LaskaKit/ESP32-LPKit/SW/ESP32-LPkit_SCD41_TMEPcz/README.md

# Výstup

Vystup dat
