LaskaKit/ESP32-LPKit/SW/ESP32-LPkit_SHT40_TMEPcz/README.md

# Výstup

Vystup dat

# Nastavení čidla

Nastaveni cidla

# Možnost debugování

debug

debug
