LaskaKit/ESP32-LPKit/img/esp32-lpkit-1.jpg

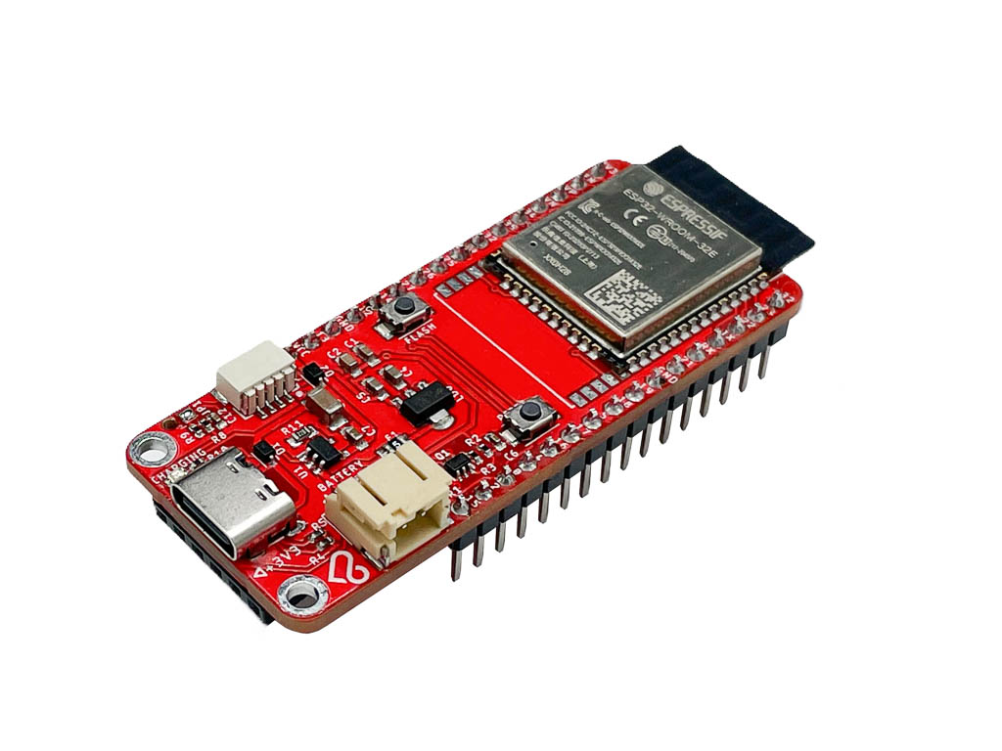
img/esp32-lpkit-1.jpg
