LaskaKit/ESP32-LPKit/img/esp32-lpkit-2.jpg

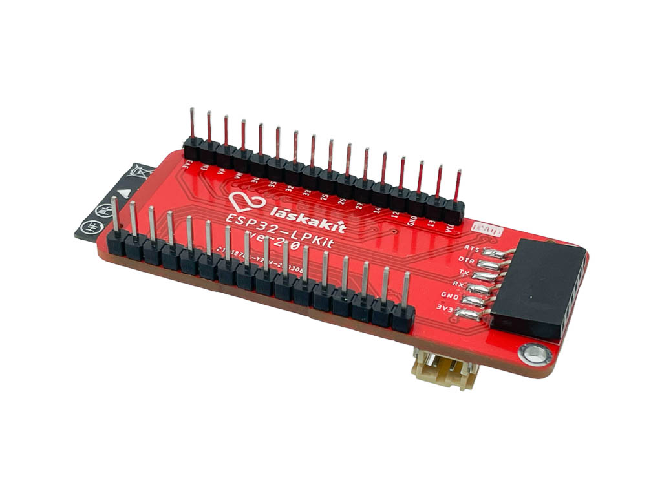
img/esp32-lpkit-2.jpg
