LaskaKit/ESP32-LPKit/img/esp32-lpkit-back.jpg

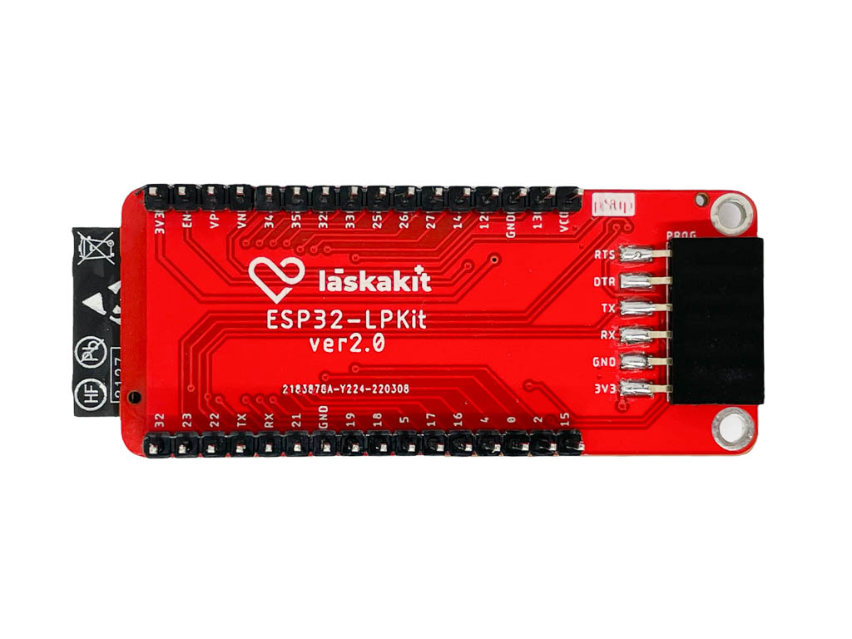
img/esp32-lpkit-back.jpg
