LaskaKit/ESP32-LPKit/img/esp32-lpkit-front.jpg

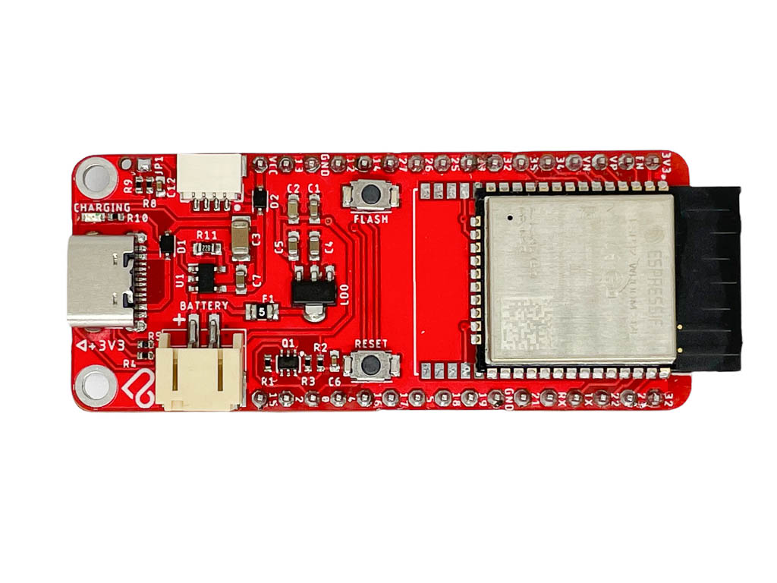
img/esp32-lpkit-front.jpg
