LaskaKit/ESP32-LPKit/img/esp32-lpkit-front_popis.jpg

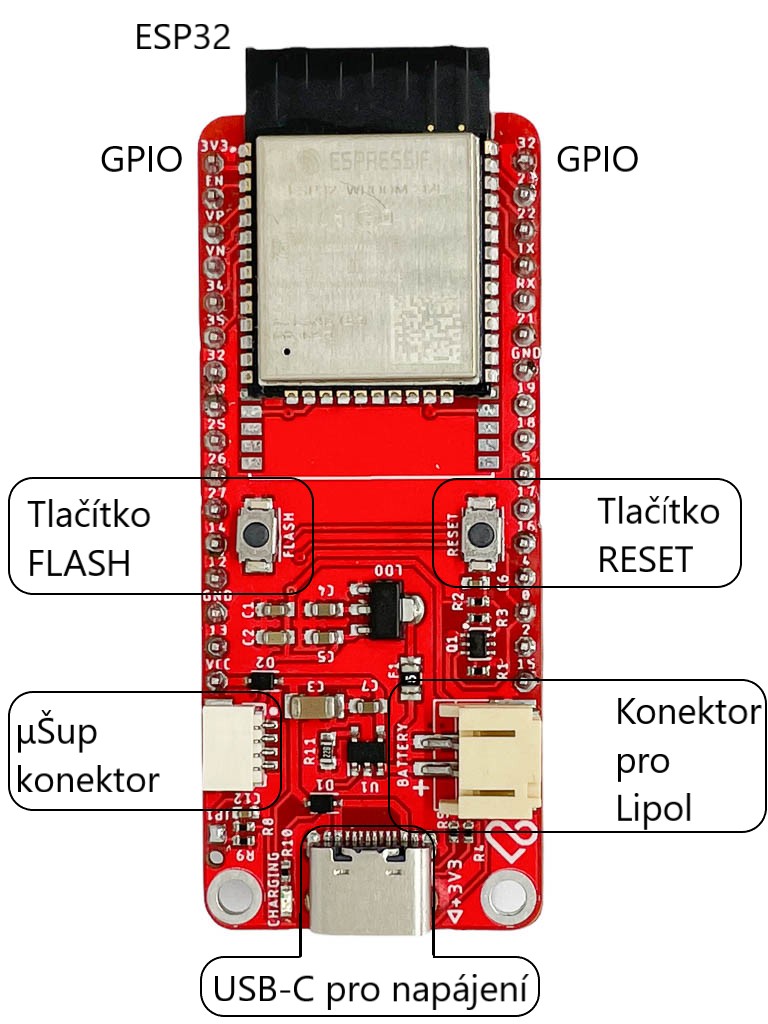
img/esp32-lpkit-front_popis.jpg
