LaskaKit/ESP32-LPKit/img/ESP32-LPkit_pinout.JPG

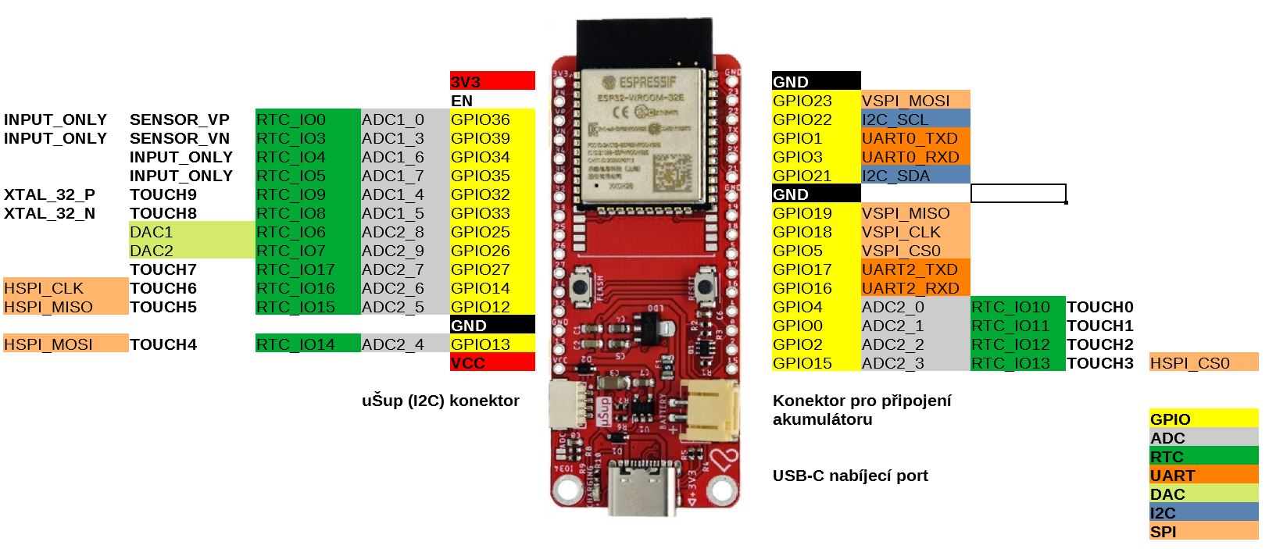
img/ESP32-LPkit_pinout.JPG
