LaskaKit/ESP32-LPKit/img/ESP32LPkit1.jpg

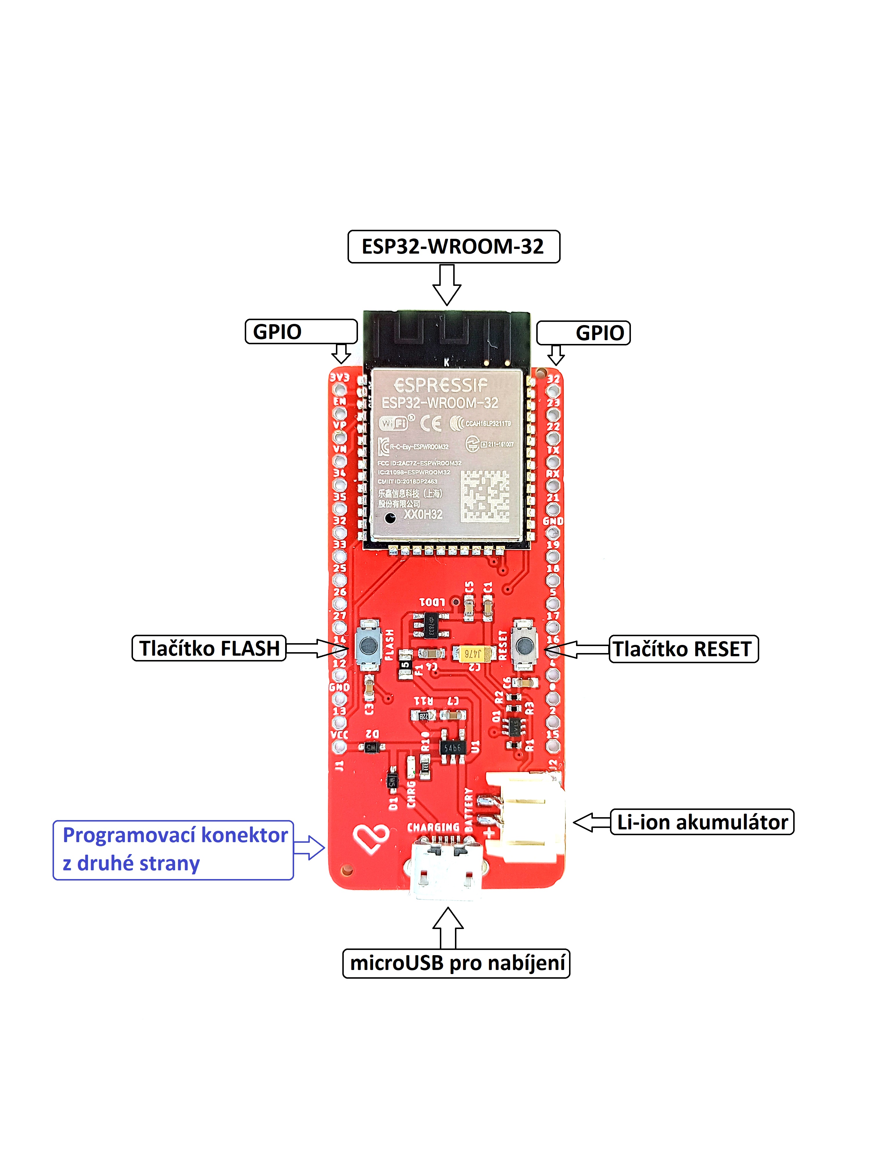
img/ESP32LPkit1.jpg
