LaskaKit/ESP32-LPKit/HW/ESP32-LPKit_V2.4.pdf

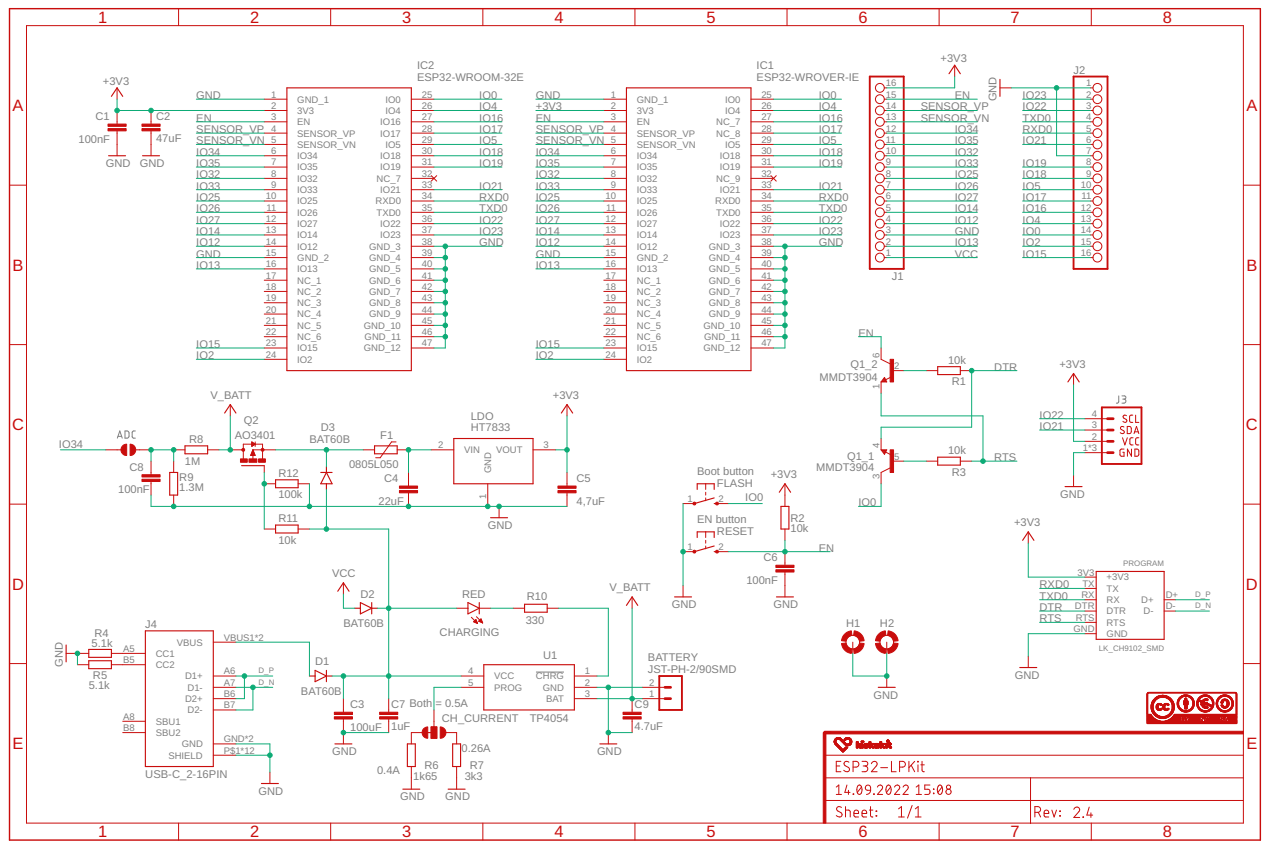
[picture p12: page 1]

39 GND_5 | GND 15 | 39 GND_5
40 GND_6 | | 40 GND_6
41 GND_7 | | 41 GND_7
42 GND_8 | | 42 GND_8
43 GND_9 | | 43 GND_9
44 GND_10 | | 44 GND_10
45 GND_11 | | 45 GND_11

Boot button EN button GND
