LaskaKit/ESP32-LPKit/HW/ESP32-LPKit_V2.2.pdf

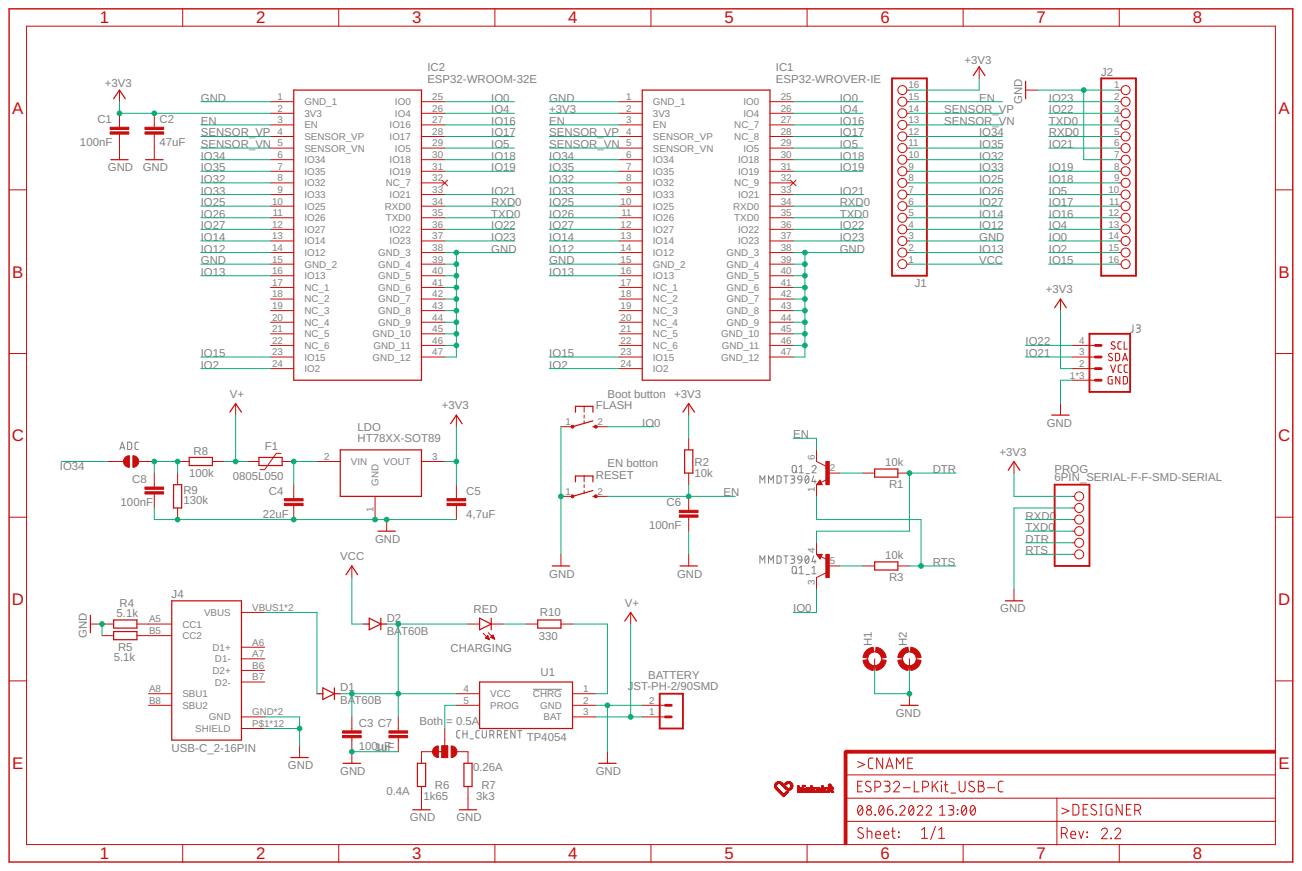
[picture p13: page 1]

Boot button EN botton
