LaskaKit/ESP32-LPKit/HW/old/ESP32-LPKit.pdf

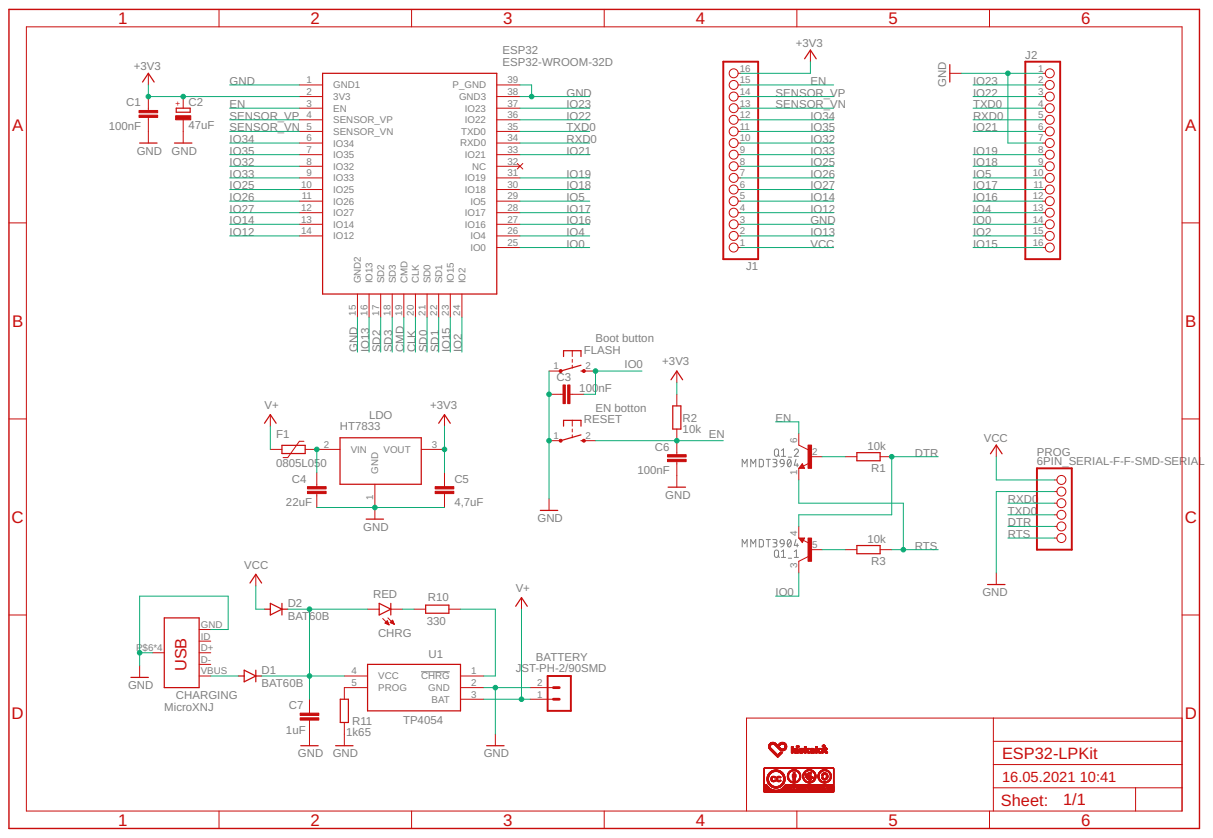
[picture p14: page 1]
