LaskaKit/ESP32-LPKit/SW/ESP32_LPkit_ADC/ESP32_LPkit_ADC.ino

/*
* Example code for ESP32-LPkit evaluation board made by laskakit.cz
* Firmware sends voltage od pin 34 through serial com port (UART)
* "laskakit.cz" 
* "ESP32 LP-kit"
* The message is sent every second
*
* Created by (c) laskakit.cz 2022
*/

#include <SPI.h>
#include <Wire.h>

#define ADCpin 34
#define deviderRatio 1.7693877551  // Voltage devider ratio on ADC pin 1MOhm + 1.3MOhm
    
void setup() {
    
  Serial.begin(115200);
  delay(100); // let serial console settle
}

void loop() {

  float bat_voltage = analogReadMilliVolts(ADCpin) * deviderRatio / 1000;
  Serial.print("Battery Voltage = " );
  Serial.print(bat_voltage);
  Serial.println("V");

  delay(2000);
}
