LaskaKit/ESP32-LPKit/SW/ESP32_LPkit_UART/ESP32_LPkit_UART.ino

/*
* Example code for ESP32-LPkit evaluation board made by laskakit.cz
* Firmware sends message through serial com port (UART)
* "laskakit.cz" 
* "ESP32 LP-kit"
* The message is sent every second
*
* Created by (c) laskakit.cz 2021
*
* Libraries:
* -
*/
 
void setup() {
  Serial.begin(115200);
  while (!Serial) 
  {
    ; // waiting for serial com port
  }
}
 
void loop() {
  Serial.println("laskakit.cz");
  Serial.println("ESP32-LPkit");
  delay(1000);
}
