LaskaKit/ESP32-LPKit/SW/ESP32_MemoryD_SCD41/src/Orbitron_Bold_24.h

// Created by http://oleddisplay.squix.ch/ Consider a donation
// In case of problems make sure that you are using the font file with the correct version!
const uint8_t Orbitron_Bold_24Bitmaps[] PROGMEM = {

  // Bitmap Data:
  0x00, // ' '
  0xF7,0xBD,0xEF,0x7B,0xDE,0xF7,0xBD,0xE0,0x03,0xDE,0xF0, // '!'
  0xFE,0xFE,0xFE,0xFE, // '"'
  0x03,0x87,0x81,0xE1,0xC0,0x70,0xF3,0xFF,0xFE,0xFF,0xFF,0xBF,0xFF,0xEF,0xFF,0xF8,0x38,0x70,0x1C,0x1C,0x07,0x0E,0x0F,0xFF,0xF3,0xFF,0xFC,0xFF,0xFF,0x0E,0x1C,0x07,0x87,0x01,0xC3,0xC0,0x70,0xE0,0x00, // '#'
  0x01,0xC0,0x00,0x70,0x00,0x1C,0x01,0xFF,0xFC,0xFF,0xFF,0xBF,0xFF,0xEE,0x1C,0x3B,0x87,0x00,0xE1,0xC0,0x38,0x70,0x0F,0xFF,0xF3,0xFF,0xFE,0x7F,0xFF,0x80,0x70,0xE0,0x1C,0x3B,0x87,0x0E,0xE1,0xC3,0xBF,0xFF,0xEF,0xFF,0xF1,0xFF,0xF8,0x01,0xC0,0x00,0x70,0x00, // '$'
  0x3E,0x00,0x61,0xFC,0x03,0x8F,0xF8,0x1E,0x38,0xE0,0xF8,0xE3,0x87,0xC3,0x8E,0x3C,0x0F,0xFB,0xE0,0x1F,0xDF,0x00,0x00,0xF8,0x00,0x07,0xDF,0xC0,0x3E,0xFF,0x03,0xE3,0x8E,0x1F,0x0E,0x38,0xF8,0x38,0xE3,0xC0,0xFF,0x8E,0x03,0xFC,0x20,0x07,0xE0, // '%'
  0x3F,0xFF,0x01,0xFF,0xF8,0x1F,0xFF,0xE0,0xE0,0x07,0x07,0x00,0x38,0x38,0x00,0x01,0xE0,0x00,0x0F,0xC0,0x00,0xFF,0x83,0x87,0x3F,0x1C,0x38,0x7E,0xE1,0xC0,0xFF,0x0E,0x01,0xFC,0x70,0x03,0xF3,0xFF,0xFF,0xCF,0xFF,0xFE,0x3F,0xFF,0x10, // '&'
  0xF7,0xBD,0xE0, // '''
  0x79,0xEF,0xB8,0xE3,0x8E,0x38,0xE3,0x8E,0x38,0xE3,0x8F,0x9E,0x38, // '('
  0xF3,0xEF,0x8E,0x38,0xE3,0x8E,0x38,0xE3,0x8E,0x38,0xEF,0xBC,0xE0, // ')'
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
    {   967,  17,  17,  19,    1,  -17 }, // 'E'
    {  1004,  17,  17,  18,    1,  -17 }, // 'F'
    {  1041,  19,  17,  21,    1,  -17 }, // 'G'
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
};
const GFXfont Orbitron_Bold_24 PROGMEM = {
(uint8_t  *)Orbitron_Bold_24Bitmaps,(GFXglyph *)Orbitron_Bold_24Glyphs,0x20, 0x7E, 24};
