LaskaKit/ESP32-LPKit/SW/ESP32_MemoryD_SCD41/src/Orbitron_Bold_42.h

// Created by http://oleddisplay.squix.ch/ Consider a donation
// In case of problems make sure that you are using the font file with the correct version!
const uint8_t Orbitron_Bold_42Bitmaps[] PROGMEM = {

	// Bitmap Data:
	0x00, // ' '
	0xFD,0xFB,0xF7,0xEF,0xDF,0xBF,0x7E,0xFD,0xFB,0xF7,0xEF,0xDF,0xBF,0x7E,0xFD,0xFB,0xF7,0xEF,0xDF,0x80,0x00,0xFD,0xFB,0xF7,0xEF,0xDF,0x80, // '!'
	0xFD,0xFB,0xF7,0xEF,0xDF,0xBF,0x7E,0xFD,0xFB,0xF7,0xEF,0xDF,0x80, // '"'
	0x00,0x1F,0x80,0xFC,0x00,0x1F,0x00,0xF8,0x00,0x3F,0x01,0xF8,0x00,0x3F,0x01,0xF8,0x00,0x3E,0x01,0xF0,0x00,0x7E,0x03,0xF0,0x3F,0xFF,0xFF,0xFE,0x3F,0xFF,0xFF,0xFE,0x3F,0xFF,0xFF,0xFE,0x3F,0xFF,0xFF,0xFE,0x3F,0xFF,0xFF,0xFE,0x3F,0xFF,0xFF,0xFE,0x01,0xF8,0x0F,0xC0,0x01,0xF0,0x0F,0x80,0x01,0xF0,0x1F,0x80,0x03,0xF0,0x1F,0x80,0x03,0xE0,0x1F,0x00,0x03,0xE0,0x3F,0x00,0xFF,0xFF,0xFF,0xFC,0xFF,0xFF,0xFF,0xFC,0xFF,0xFF,0xFF,0xFC,0xFF,0xFF,0xFF,0xFC,0xFF,0xFF,0xFF,0xFC,0x0F,0x80,0x7C,0x00,0x1F,0x80,0xFC,0x00,0x1F,0x80,0xFC,0x00,0x1F,0x00,0xF8,0x00,0x1F,0x01,0xF8,0x00,0x3F,0x01,0xF8,0x00,0x3E,0x01,0xF0,0x00, // '#'
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
	  {  2861,  29,  30,  33,    2,  -30 }, // 'E'
	  {  2970,  29,  30,  31,    2,  -30 }, // 'F'
	  {  3079,  32,  30,  36,    2,  -30 }, // 'G'
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
};
const GFXfont Orbitron_Bold_42 PROGMEM = {
(uint8_t  *)Orbitron_Bold_42Bitmaps,(GFXglyph *)Orbitron_Bold_42Glyphs,0x20, 0x7E, 43};
