LaskaKit/ESP32-LPKit/SW/ESP32_MemoryD_SCD41/src/Orbitron_Bold_72.h

// Created by http://oleddisplay.squix.ch/ Consider a donation
// In case of problems make sure that you are using the font file with the correct version!
const uint8_t Orbitron_Bold_72Bitmaps[] PROGMEM = {

	// Bitmap Data:
	0x00, // ' '
	0xFF,0xDF,0xFB,0xFF,0x7F,0xEF,0xFD,0xFF,0xBF,0xF7,0xFE,0xFF,0xDF,0xFB,0xFF,0x7F,0xEF,0xFD,0xFF,0xBF,0xF7,0xFE,0xFF,0xDF,0xFB,0xFF,0x7F,0xEF,0xFD,0xFF,0xBF,0xF7,0xFE,0xFF,0xDF,0xFB,0xFF,0x7F,0xEF,0xFD,0xFF,0xBF,0xF7,0xFE,0xFF,0xDF,0xFB,0xFF,0x7F,0xEF,0xFD,0xFF,0x80,0x00,0x00,0x00,0x00,0x00,0x00,0x7F,0xEF,0xFD,0xFF,0xBF,0xF7,0xFE,0xFF,0xDF,0xFB,0xFF,0x7F,0xE0, // '!'
	0xFF,0xCF,0xFB,0xFF,0x3F,0xEF,0xFC,0xFF,0xBF,0xF3,0xFE,0xFF,0xCF,0xFB,0xFF,0x3F,0xEF,0xFC,0xFF,0xBF,0xF3,0xFE,0xFF,0xCF,0xFB,0xFF,0x3F,0xEF,0xFC,0xFF,0xBF,0xF3,0xFE,0xFF,0xCF,0xF8, // '"'
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
	  {  2832,  27,  52,  29,    0,  -52 }, // '1'
	  {  3008,  52,  52,  61,    4,  -52 }, // '2'
	  {  3346,  52,  52,  60,    4,  -52 }, // '3'
	  {  3684,  51,  52,  54,    0,  -52 }, // '4'
	  {  4016,  52,  52,  61,    4,  -52 }, // '5'
	  {  4354,  52,  52,  60,    4,  -52 }, // '6'
	  {  4692,  44,  52,  49,    0,  -52 }, // '7'
	  {  4978,  52,  52,  61,    4,  -52 }, // '8'
	  {  5316,  52,  52,  61,    4,  -52 }, // '9'
	  {  5654,  10,  42,  16,    4,  -42 }, // ':'
	  {  5707,  10,  52,  17,    4,  -42 }, // ';'
	  {  5772,  32,  43,  35,    0,  -43 }, // '<'
	  {  5944,  39,  22,  47,    4,  -32 }, // '='
	  {  6052,  31,  44,  35,    4,  -43 }, // '>'
	  {  6223,  46,  52,  50,    2,  -52 }, // '?'
	  {  6522,  52,  52,  61,    4,  -52 }, // '@'
	  {  6860,  53,  52,  61,    4,  -52 }, // 'A'
	  {  7205,  53,  52,  61,    4,  -52 }, // 'B'
	  {  7550,  53,  52,  60,    4,  -52 }, // 'C'
	  {  7895,  53,  52,  61,    4,  -52 }, // 'D'
	  {  8240,  49,  52,  56,    4,  -52 }, // 'E'
	  {  8559,  49,  52,  53,    4,  -52 }, // 'F'
	  {  8878,  53,  52,  61,    4,  -52 }, // 'G'
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
};
const GFXfont Orbitron_Bold_72 PROGMEM = {
(uint8_t  *)Orbitron_Bold_72Bitmaps,(GFXglyph *)Orbitron_Bold_72Glyphs,0x20, 0x7E, 72};
