LaskaKit/ESP32-LPKit/(commit log)

2021-07-27 no changes
    [ESP32-LPKit_LDO_SOT-23-5_top_bom.csv, ESP32-LPKit_top_bom.csv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]
2022-03-28 new data
    [ESP32-LPKit_USB-C_top_bom.csv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]
2022-04-27 new version
    [ESP32-LPKit_LDO_SOT-23-5_top_bom.csv, ESP32-LPKit_top_bom.csv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]
2022-05-04 Create ESP32-LPkit_SHT40_TMEPcz.ino
2022-05-26 new schematic and example
    [ESP32-LPKit_USB-C_top_bom.csv]
2022-06-27 new design
    [ESP32-LPKit_USB-C_top_bom.csv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]
2022-08-01 new version, see version.md
    [ESP32-LPKit_USB-C_MODULE_PROG_top_bom.csv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]
2022-08-22 ADC update
2022-09-27 name changers
    [ESP32-LPKit_USB-C_MODULE_PROG_top_bom.csv, ESP32-LPKit_USB-C_top_bom.csv, ESP32-LPKit_v2_4_top_bom.csv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]
2023-02-18 data update
    [ESP32-LPKit_IPEX_v2_4_top_bom.csv, ESP32-LPKit_PCB_v2_4_top_bom.csv]
2024-01-26 Update ESP32-LPkit_SCD41_TMEPcz.ino
    Added missing semicolon.
    [ESP32-LPkit_SCD41_TMEPcz.ino]
2024-08-18 "Fix ADC reading"
